DoHyun0226/zetin-drone/docs/current_status.md

# 현재 상태와 다음 작업

**문서 대조일: 2026-10-15.** 저장 로그·노션 실험 기록과 `main`(`1dc8582` 이후)
코드를 대조했다. 저스로틀 yaw 개선은 2026-10-14 `main`에 통합됐다.
마지막 비행은 2026-08-19이며, 이 문서 갱신은 새 비행 결과가 아니다. 동작 정본은 현재 기본 지원 코드
`firmware/flight/dual_imu_cascade_pwm/`이며, 최신 실험 결과는 아래 적용 범위와 함께 읽는다.

## 한눈에 보기

| 구분 | 현재 상태 | 근거·다음 확인 |
|---|---|---|
| 자세 제어 | 듀얼 IMU·캐스케이드 PID·yaw 자동 잠금·자기계 보정 구현. 8월 1일 176.2초 연속 무장 기록 | [개요](project_overview.md), [벤치·비행 기록](power_on_bench_procedure.md) |
| 최근 실험 | 8월 19일 테더 이륙→수동 호버→착륙 5회 기록. 조종자와 테더가 포함된 결과 | [해당 노션 기록](https://app.notion.com/p/3c62d27b08d3811398e7f4defe58351c) |
| 제어 배분 | roll/pitch 우선·잔여 범위 yaw 배분, yaw 권한 상태·무장 확인. 2026-10-14 `main` 통합 | 무장 거부·확인 시간 초과·failsafe 경로 실기 미검증 |
| 자동착륙 | RC 단절 시 조건에 따라 즉시 컷 또는 시간 기반 하강. 착지 감지 미사용 | [프로토콜](udp_protocol.md), [착지 연구](failsafe_land_research.md) |
| 거리·광류 | 3901-L0X 수신·기록 코드 있음. 최근 시험에서 신선한 값 미확보 | 품질·거리·지연부터 벤치 측정. 고도·위치 제어는 미구현 |
| 호버 추정 | 수평·가속도·스로틀 조건으로 학습. 실제 공중 판별 아님 | 지상에서도 `Hover_Valid`가 성립하고 추정치가 오염되는 기록 있음 |
| 하드웨어 | FC는 PCB v1.5.2. 연산·센서·PWM 경로는 코드로 확인 가능. 구매 목록은 확인 필요 | [하드웨어 구성](hardware_configuration.md) |

## 최신 실험과 기본 지원 코드의 관계

8월 19일 다섯 사이클은 `feat/low-throttle-yaw-control`(`a052dd9`) 구성으로
비행했다. 이 브랜치는 2026-10-14 `main`에 통합됐다(`1dc8582`). 통합된 펌웨어는
비행한 코드와 주석만 다르므로, 축 우선순위 배분·yaw 권한 상태의 비행 기록은
현재 기본 코드에도 해당한다.
통합 전 실기 게이트는 [벤치 절차](power_on_bench_procedure.md)의 2026-10-14
기록으로 대조했다. 4단계는 다섯 사이클로 통과했고, 1–3단계는 수행자 확인만 있고
수치는 남아 있지 않다.

통합 직전에 지상국 무장 확인을 고쳤다(`98df52e`). 확인 시간이 지난 뒤 도착하거나
판정된 `Armed=1`을 무장 성공으로 받아들이던 결함이다. 이 수정과 무장 거부·확인
시간 초과·failsafe 경로는 아직 비행 기록이 없다. 다섯 사이클을 무조종 위치 유지
성공으로 옮겨 쓰지 않으며, 실제 기체에 마지막으로 업로드된 커밋은 소스 폴더나
로그 파일명만으로 확정할 수 없다.

## 다음 작업과 완료 조건

아래는 코드·기록에서 확인되는 남은 작업이다. 담당자·진행 일정은 아직 확인되지
않았으므로 배정된 업무나 진행 중 상태로 표시하지 않는다.

| 순서 | 작업 | 다음 행동 | 완료를 판단할 근거 |
|---|---|---|---|
| 1 | 시험 구성 고정 | 펌웨어·지상국 커밋, 보드·배터리·테더·센서 배선, 담당자 기록 | 같은 구성과 로그를 다시 찾을 수 있는 시험 메모 |
| 2 | 거리·광류 수신 확인 | 무추력 상태에서 전원·배선·UART·프레임·신선도 순서로 점검 | 알려진 거리/이동에 대한 값과 연결 중단 후 무효화 기록 |
| 3 | 호버 추정의 지상 오염 | 접촉/공중 라벨과 `Hover_Est`·`Hover_Valid` 동시 수집 | 지상 출발·착륙 구간을 분리한 실패 재현과 개선 검증 |
| 4 | 통합 코드의 실패 경로 실기 확인 | 아직 실기 미검증인 무장 거부·확인 시간 초과(`98df52e` 포함)·failsafe 경로 확인 | 통합 커밋·시험 조건·명령·텔레메트리가 대응되는 실기 기록 |
| 5 | 접지 후 진동 확인 | 고정한 시험 조건에서 접촉과 정지 시각을 함께 기록 | 접촉 즉시 무장 해제 조건의 비교 결과. PID 원인으로 단정하지 않음 |
| 6 | 착지 감지·고도·위치 제어 | 유효한 센서 관측과 충분한 라벨 자료 확보 후 설계 | 오발화·미검출·센서 두절·범위 밖 조건까지 검증 |

## 현재 검증과 남은 관문

2026-10-14 기본 코드의 Python 테스트 및 호스트 네이티브/SIL 실행을 포함한
`unittest` **200개가 skip 없이 통과**했다. 이 개수는 바깥 테스트 개수이며 내부 C++
케이스를 다시 합산하지 않는다. 같은 커밋의 `main` CI에서 주력·보류 후보·진단
**9개 스케치가 ESP32 코어 3.3.10으로 컴파일 통과**했다. 2026-09-07 점검의
빌드·검사 기록은 [정합성 점검 기록](reports/2026-09-07-documentation-audit.md)에 있다.

기체 없는 검사와 과거 실비행 기록을 구분한다. 새로운 센서 수신 성공, 최신
보드 빌드의 비행 성능, 현재 배터리·기구 상태를 이번 문서 점검으로 확정하지 않는다.
작업 시작·종료 절차는 [작업 흐름](workflow.md)을 따른다.
