DoHyun0226/zetin-drone/(commit log)

2026-09-21 ci: run the native tests instead of silently skipping them
    The tests in tools/ that build firmware logic at ESP32 integer width shell out
    to g++ -m32. ubuntu-latest has no multilib, so the link fails, and each of
    those tests calls skipTest rather than raising. Run 34104011215 (2026-09-07)
    ended "Ran 175 tests ... OK (skipped=7)": failsafe land, attitude SIL, the
    control-math compile-time guard, the BMM350 SIL, the MSP sensor parser and the
    yaw command were all green without ever running. The same seven pass locally
    where multilib is present, so nothing was broken -- CI just was not looking.
    Installing gcc-multilib and g++-multilib fixes today's cause. It does not fix
    the shape of the failur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
2026-09-21 Test commit: requirements-복사본.txt 추가이나 삭제후 재커밋 예정
2026-10-14 fix: refuse an arm confirmation that is judged after the deadline
    advance_arm_attempt() accepted Armed=1 before it looked at the deadline,
    and the receive loop handed it the packet's receipt time. check_arm_timeout()
    runs before recvfrom(), so a packet received just inside the deadline but
    judged after it -- or one that simply arrived after it -- armed the ground
    station, opened RC streaming at throttle 1100 and never sent stop. The
    attempt the operator had been told was abandoned went live instead.
    The deadline is now checked before the success branch, against the time
    taken after safety_cmd_lock is held, so trim resends, printing and lock
    waits between receipt and judgment count against i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
2026-10-14 docs: describe the merged low-throttle yaw code as the current code
    The low-throttle yaw work reached main on 2026-10-14 (1dc8582), but the
    explanatory docs still framed it as a feature branch combined into a
    working tree, and several statements described the mixer and ground
    station as they were before it.
    - README, current_status: merge state, the HW gate record, the arm
    deadline fix (98df52e), and the counts from that commit's CI run
    (200 tests without skips, 9 sketches compiled on core 3.3.10).
    - cascade_vs_single_pid: roll/pitch-first allocation with separate
    rp/yaw scales, the per-axis integral rule (only accumulation that
    deepens that axis's saturation is skipped), and the ya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
2026-10-22 docs: record PCB v1.5.2 as the board in use for all flights
2026-10-27 docs: annotate tuning params, system constants, and yaw hold logic
    Study-note comments on the flight firmware's tuning parameters, pin map,
    ESC/sensor constants, failsafe and hover-estimate thresholds, and the
    yaw hold/command helpers. No behavior change.
2026-10-27 docs: annotate allocator, yaw authority, failsafe, MSP parser, and main loop
    Korean study-note comments across the flight firmware: motor allocation
    priority and yaw scale, yaw authority state machine and conditional
    integration, auto-land and hover estimation helpers, MSPv2 parser state
    machine, mag heading fusion, and the pid_task/udp_task flow in the
    sketch. Comments only; stripped code is identical to the previous commit.
2026-10-30 docs: annotate FreeRTOS tick timing, IMU init, and reading progress
2026-10-30 docs: annotate watchdog, IMU read status, accel scale, and disagreement check
    Reading progress (2026-10-31): dual_imu_cascade_pwm.ino line 1527,
    in pid_task just before the "IMU 융합" section.
2026-11-02 docs(camera): record the bottleneck capture and the UDP comparison
    The TCP capture showed a steady 75 kB/s with no retransmissions and
    in-flight data capped at the 5744 B send buffer, so the send buffer and
    round trip are the likely limit but not a proven one. A throwaway UDP
    build at the same cap lost half or more of its frames. Also note that
    WiFi power save can come back on despite the connection profile.
    Claude-Session: https://claude.ai/code/session_01GcHUPL2nqsZmco3ANeS5w6
2026-11-02 docs(camera): record the evening quality and UDP rerun bench
    Interleaved q10/q12/q14 runs showed throughput swinging 47-88 kB/s
    with the camera round trip, which outweighs the small fps gain from
    q14, so q10 stays the default. The UDP rerun at 60 and 90 kB/s gave no
    reason to leave TCP.
    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
2026-11-02 fix(camera): run the sensor clock at 12 MHz instead of 20 MHz
    With the sensor powered down and only the 20 MHz XCLK running, the
    camera's TCP throughput fell from 219/254 to 69/81 kB/s and the stream
    managed 5.0 and 0.65 fps. Both cores were mostly idle and lowering the
    capture task priority changed nothing, so this is clock-dependent link
    degradation rather than CPU load. At 12 MHz the stream reached 9.3-9.7
    fps with every frame decoding; 24 MHz corrupts frames.
    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
2026-11-02 docs(ground): design and plan for the ground-station script cleanup
    Three entry points (control, video, logs) replace the twenty-odd scripts,
    and the control station becomes a fixed dashboard. The plan keeps the
    existing safety flow and tests, and was reviewed three times: a
    recomputation against the source, an adversarial Codex review, and an
    independent agy review.
    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
2026-11-02 refactor(ground): move shared telemetry and camera modules into scripts/ground
    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
2026-11-02 refactor(ground): add drone_logs.py and move the log analyzers under it
    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
2026-11-02 test(ground): assert the legacy allocator summary in the drone_logs flight smoke test
    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
2026-11-02 refactor(ground): add drone_video.py for camera recording and mp4 export
    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
2026-11-02 refactor(ground): move the DualSense control station to scripts/ground/control_station.py
    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
2026-11-02 refactor(ground): route control station output through a UI object and stop RC when a worker dies
    All 74 print calls go through ui.event / ui.periodic (ConsoleUI keeps the
    old output byte for byte); the bottom of the module becomes main(argv, ui).
    Safety changes, each pinned by a test:
    - a telemetry/controller worker exception latches worker_fault, cancels
    any arm/resume attempt, stops RC with stop_streaming_only, then alerts;
    while latched arm/resume are refused and no rc/rcr is sent
    - EOF on stdin disarms like Ctrl+C when armed or arming
    - a second station on UDP 4210 exits with code 1 before creating logs
    Claude-Session: https: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
2026-11-02 test(ground): pin the controller's own rcr guard under the worker-fault latch
    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
2026-11-02 fix(ground): keep RC behind the fault latch and run safety before fault output
    - rc/rcr latch check + sendto and the worker_fault write share rc_send_lock,
    so no rc/rcr can leave after the latch is written
    - [FAULT] lines for telemetry loss, drone RC timeout, critical fault and
    drone-side disarm are buffered and flushed after stop_streaming_only /
    disarm; console text and order are unchanged
    - resume rejections and the "resume sent" event are emitted after the
    state locks are released
    - ConsoleUI.run never raises: a broken input stream ends through on_eof,
    a failing command is reported and the loop continues
    Claude-Session: h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
2026-11-02 fix(ground): run the EOF safety callback before reporting a broken stdin
    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
2026-11-03 feat(ground): add the dashboard view model
    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
2026-11-03 fix(ground): keep the console free of prompt_toolkit and fix dashboard height and CW-CCW
    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
2026-11-03 feat(ground): show the control station as a fixed dashboard
    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
2026-11-03 fix(ground): run the dashboard EOF safety before teardown, forward the console fallback and keep Ctrl+D to an empty line
    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
2026-11-03 feat(ground): add drone_control.py with keyboard and listen modes
    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
2026-11-03 fix(ground): publish bad-packet counts on malformed-only traffic and hide pad hints outside pad mode
    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
2026-11-03 refactor(ground): fold the telemetry plot and gamepad check into drone_control
    --listen --plot runs ground/monitor_plot.py and --pad-check runs
    ground/pad_check.py; both are dispatched before control_station is
    imported, so neither binds the station port nor creates station logs.
    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
2026-11-03 fix(ground): bind the plot port before creating its log and cap redraw at 10 Hz
    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
2026-11-03 docs(ground): describe the three ground tools and archive the bench scripts
    Move the bench and special-firmware scripts to scripts/archive/, rewrite
    scripts/README.md around drone_control/drone_video/drone_logs, add the
    migration map rows, mark the old script names as stale tokens and update
    firmware hint strings/comments (no logic change).
    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
2026-11-03 docs(ground): keep the historical tool names in the 2026-07-29 bench record
    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
2026-11-03 fix(ground): show the drone's armed state on the dashboard apart from the station's
    The banner used the local is_armed, which is always false in --listen and
    --keyboard, so an armed drone could show a green DISARMED. The top bar now
    shows the firmware Armed field (fresh telemetry only, "?" otherwise) and the
    local control state separately, and flags a mismatch either way right after
    the banner so it survives a narrow terminal.
    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
2026-11-03 fix(ground): disarm on every station exit path and keep the dashboard current
    Final branch review fixes for the control path:
    - A Ctrl+C while the dashboard is being built, and anything that escapes
    ui.run(), still runs the pad-mode conditional disarm before cleanup.
    - Event-loop exceptions in the dashboard run the Ctrl+C safety callback
    first and then leave the app, instead of prompt_toolkit's "Press ENTER".
    - SIGTERM takes the Ctrl+C path (dashboard SIGINT key or KeyboardInterrupt),
    so the terminal is restored; after the UI returns it no longer interrupts
    the log saving.
    - The dashboard pulls snapshot() on its own redraw, and main publishes one
    at start, so disarm/RC stop/worker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
2026-11-03 test(ground): pin the drone_video unknown-subcommand exit code and message
    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
2026-11-03 fix(ground): treat an internal dashboard error as a fault, not an operator stop
    An exception in the dashboard's event loop or redraw no longer runs the
    Ctrl+C conditional disarm (a mid-air stop). The station handles it like a
    dead worker: latch worker_fault="dashboard", cancel any arm/resume attempt,
    stop RC without a stop packet so the drone's RC-timeout autoland takes over,
    all before any diagnostic. The UI then falls back to line output and keeps
    running until Ctrl+C; Ctrl+C, SIGTERM and Ctrl+D keep their semantics.
    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
2026-11-03 fix(ground): draw dashboard labels in cyan instead of bright black
    Bright black is the background colour in some terminal themes, so the
    labels, separators, hints and event times disappeared on the bench
    laptop's kitty theme.
    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
2026-11-03 fix(ground): wrap long dashboard events instead of cutting them off
    The [GAINS] reply ran past the right edge of the event area and the
    numbers beyond it were never shown. Events now continue on indented
    lines that fit the terminal width.
    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
2026-11-03 fix(ground): skip raw IMU datagrams in the telemetry plot
    With the drone's raw IMU stream on, the plot tried to decode every ZIMU
    and ZCAL datagram as text, printed a bad-telemetry warning for each and
    counted them as bad packets. It now recognizes them, skips them and
    reports how many arrived.
    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
2026-11-03 docs(catalog): record the flow-hold tether flights in the catalog row
    The row still said the sketch was only checked on the host and in SIL,
    but the plan's record has five tethered position-hold flights on
    2026-10-30. Altitude hold has not been flown.
    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
